dmitryshagin/xenon_motor_control/README.md

# xenon_motor_control
Board to control xenon headlight position with conventional halogen control for VW Passat B5+ car.
Bolt-con connectors that fit: Pigtail 968813-9C 0-1452576-8
https://aliexpress.ru/item/4000353686621.html?spm=a2g0s.9042311.0.0.ddc433edCFKElc
