dmitryshagin/xenon_motor_control/xenon_mini.brd

## EAGLE design xenon_mini.brd (2020-10-16)

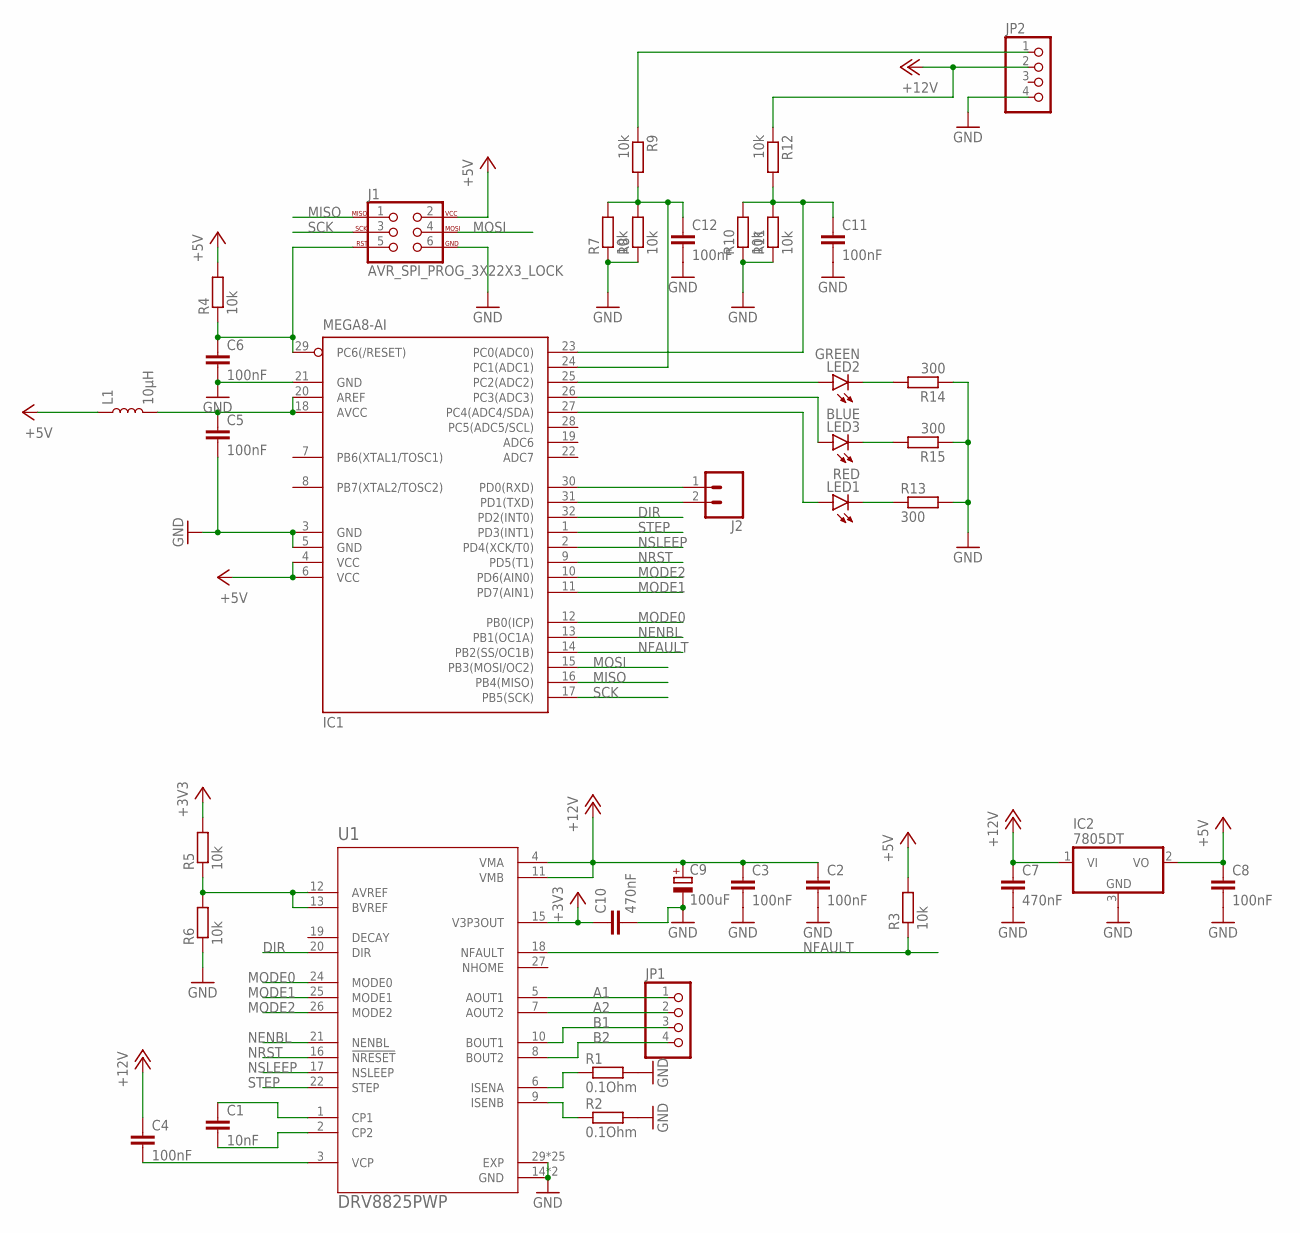
[picture p1: schematic xenon_mini.sch]

Parts:
C1: 10nF; C0603; LCSC C57112
C2, C3, C4, C8: 100nF; C0603; LCSC C14663
C5, C6, C11, C12: 100nF; C0603; LCSC CC0603KRX7R9BB104
C7, C10: 470nF; C0603; LCSC C1623
C9: 100uF; UD-6,3X7,7_NICHICON; LCSC C176675
IC1: MEGA8-AI; TQFP32-08; LCSC C8727
IC2: 7805DT; TO252; LCSC C310413
J1: AVR_SPI_PROG_3X22X3_LOCK; 2X3_LOCK
J2: CONN_02LOCK; 1X02_LOCK
JP1, JP2: PINHD-1X4; 1X04
L1: 10μH; 0805; LCSC C1046
LED1: RED; SML0603; LCSC C2286
LED2: GREEN; SML0603; LCSC C72043
LED3: BLUE; SML0603; LCSC C72041
R1, R2: 0.1Ohm; R1206; LCSC C25334
R3, R4, R5, R6, R7, R8, R9, R10, R11, R12: 10k; R0603; LCSC C25804
R13, R14, R15: 300; R0603; LCSC C23025
U1: DRV8825PWP; SOP65P640X120-29N; LCSC C81582

Connections:
+3V3: C10.1, R5.2, U1.15 (V3P3OUT)
+5V: C8.1, IC1.4 (VCC), IC1.6 (VCC), IC2.2 (VO), J1.2, L1.1, R3.2, R4.2
+12V: C2.1, C3.1, C4.1, C7.1, C9.+, IC2.1 (VI), JP2.2, R12.1, U1.4 (VMA), U1.11 (VMB)
A1: JP1.1, U1.5 (AOUT1)
A2: JP1.2, U1.7 (AOUT2)
B1: JP1.3, U1.10 (BOUT1)
B2: JP1.4, U1.8 (BOUT2)
DIR: IC1.32 (PD2(INT0)), U1.20 (DIR)
GND: C2.2, C3.2, C5.2, C6.2, C7.2, C8.2, C9.-, C10.2, C11.2, C12.2, IC1.3 (GND), IC1.5 (GND), IC1.21 (GND), IC2.3 (GND), J1.6, JP2.4, R1.2, R2.2, R6.1, R7.1, R8.1, R10.1, R11.1, R13.2, R14.1, R15.1, U1.14 (GND), U1.28 (GND), U1.29 (EXP), U1.P1 (EXP), U1.P2 (EXP), U1.P3 (EXP), U1.P4 (EXP), U1.P5 (EXP), U1.P6 (EXP), U1.P7 (EXP), U1.P8 (EXP), U1.P9 (EXP), U1.P10 (EXP), U1.P11 (EXP), U1.P12 (EXP), U1.P13 (EXP), U1.P14 (EXP), U1.P15 (EXP), U1.P16 (EXP), U1.P17 (EXP), U1.P18 (EXP), U1.P19 (EXP), U1.P20 (EXP), U1.P21 (EXP), U1.P22 (EXP), U1.P23 (EXP), U1.P24 (EXP)
MISO: IC1.16 (PB4(MISO)), J1.1
MODE0: IC1.12 (PB0(ICP)), U1.24 (MODE0)
MODE1: IC1.11 (PD7(AIN1)), U1.25 (MODE1)
MODE2: IC1.10 (PD6(AIN0)), U1.26 (MODE2)
MOSI: IC1.15 (PB3(MOSI/OC2)), J1.4
unnamed: C1.1, U1.1 (CP1)
unnamed: C1.2, U1.2 (CP2)
unnamed: C4.2, U1.3 (VCP)
unnamed: R1.1, U1.6 (ISENA)
unnamed: R2.1, U1.9 (ISENB)
unnamed: C6.1, IC1.29 (PC6(/RESET)), J1.5, R4.1
unnamed: C12.1, IC1.24 (PC1(ADC1)), R7.2, R8.2, R9.2
unnamed: C11.1, IC1.23 (PC0(ADC0)), R10.2, R11.2, R12.2
unnamed: LED1.C, R13.1
unnamed: JP2.1, R9.1
unnamed: R5.1, R6.2, U1.12 (AVREF), U1.13 (BVREF)
unnamed: IC1.30 (PD0(RXD)), J2.1
unnamed: IC1.31 (PD1(TXD)), J2.2
unnamed: IC1.25 (PC2(ADC2)), LED2.A
unnamed: IC1.26 (PC3(ADC3)), LED3.A
unnamed: LED2.C, R14.2
unnamed: LED3.C, R15.2
unnamed: IC1.27 (PC4(ADC4/SDA)), LED1.A
unnamed: C5.1, IC1.18 (AVCC), IC1.20 (AREF), L1.2
NENBL: IC1.13 (PB1(OC1A)), U1.21 (NENBL)
NFAULT: IC1.14 (PB2(SS/OC1B)), R3.1, U1.18 (NFAULT)
NRST: IC1.9 (PD5(T1)), U1.16 (!NRESET)
NSLEEP: IC1.2 (PD4(XCK/T0)), U1.17 (NSLEEP)
SCK: IC1.17 (PB5(SCK)), J1.3
STEP: IC1.1 (PD3(INT1)), U1.22 (STEP)

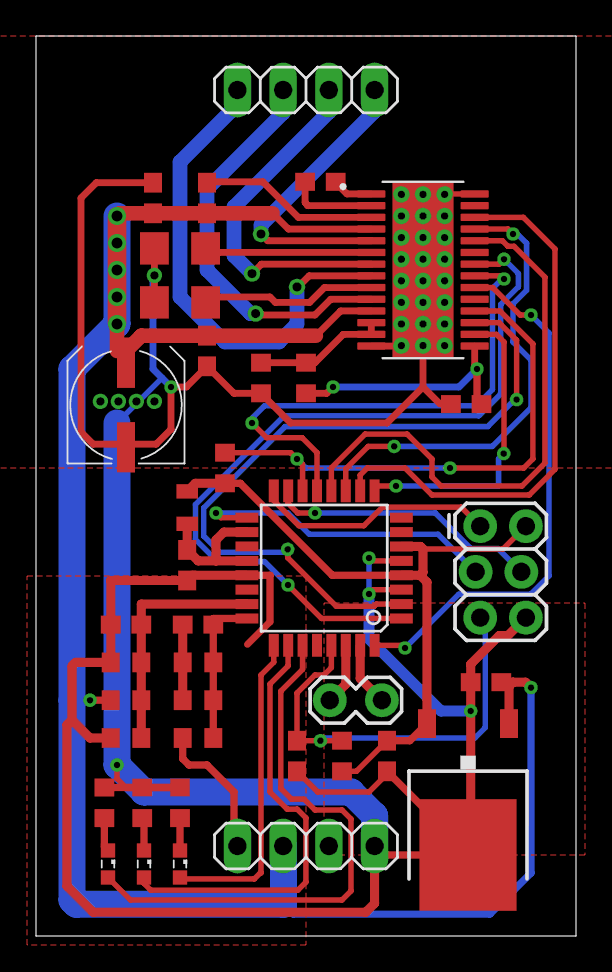
[picture p2: board xenon_mini.brd from above]

Board: 2 copper layers, 30.0 x 50.0 mm, 38 parts (0 on the bottom side), 39 nets.
