dmitryshagin/xenon_motor_control/(commit log)

2020-12-15 Make movement more syncronous for two motors
2021-10-12 Making regulation limits smaller + less jitter
    [bt_car_stepper_control_mini.ino]
